MagnusKos/SlotRa_PCB/SlotRa.kicad_pcb

## KiCad design SlotRa.kicad_pcb (2025-05-28)

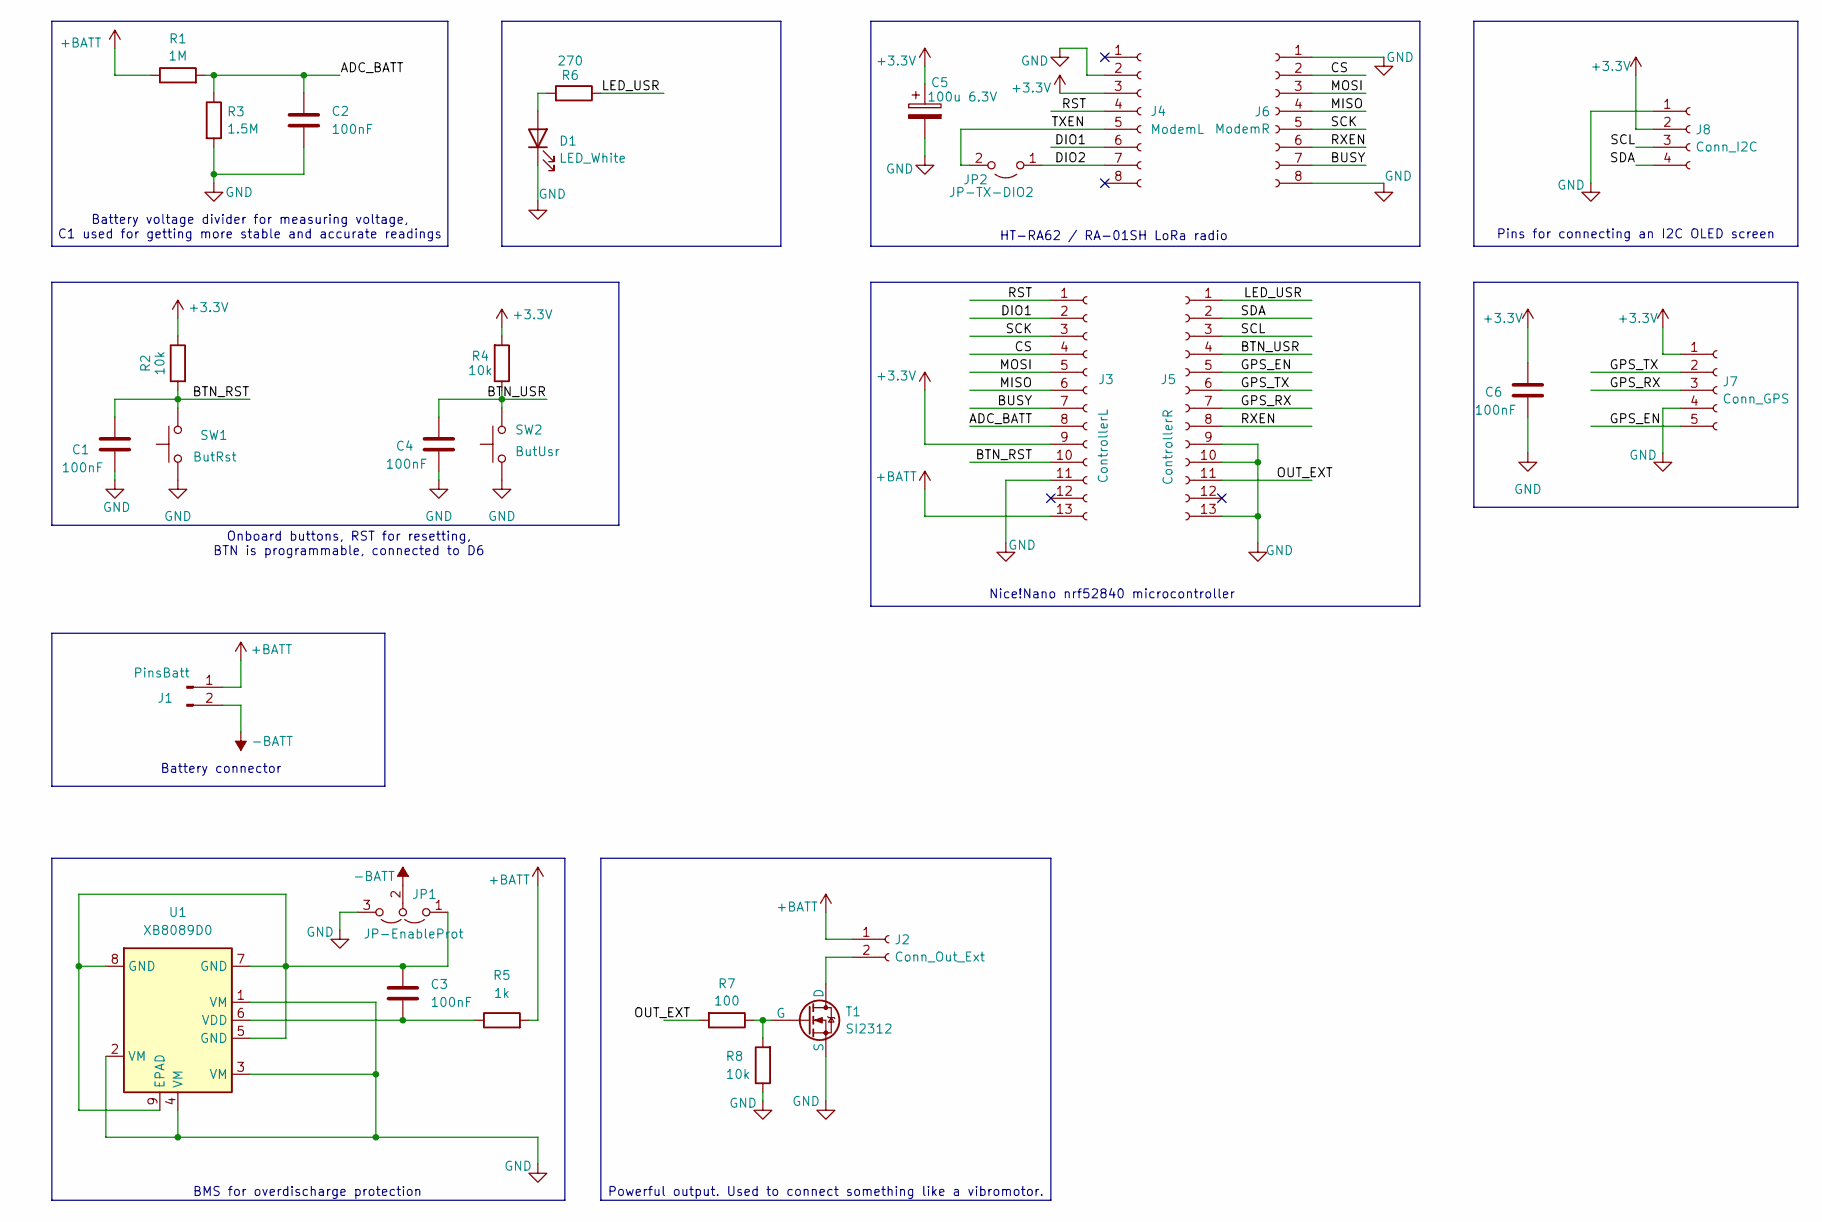
[picture p4: schematic SlotRa.kicad_sch, SlotRa (fakeTec_v5 mod)]

Parts:
C1, C2, C3, C4, C6: 100nF; C_0805_2012Metric_Pad1.18x1.45mm_HandSolder
C5: 100u 6.3V; CP_EIA-7343-31_Kemet-D
D1: LED_White; LED_D3.0mm_Horizontal_O6.35mm_Z10.0mm
J1: PinsBatt; PinHeader_1x02_P2.54mm_Vertical
J2: Conn_Out_Ext; PinHeader_1x02_P2.54mm_Vertical
J3: ControllerL; SMD_Pad_Row_P2.54_13x1
J4: ModemL; SMD_Pad_Row_P2.00_8x1_longer
J5: ControllerR; SMD_Pad_Row_P2.54_13x1
J6: ModemR; SMD_Pad_Row_P2.00_8x1
J7: Conn_GPS; PinHeader_1x05_P2.00mm_Vertical
J8: Conn_I2C; PinHeader_1x04_P2.54mm_Vertical
JP1: JP-EnableProt; SolderJumper-3_P1.3mm_Open_RoundedPad1.0x1.5mm
JP2: JP-TX-DIO2; SolderJumper-2_P1.3mm_Open_RoundedPad1.0x1.5mm
R1: 1M; R_0805_2012Metric_Pad1.20x1.40mm_HandSolder
R2, R4, R8: 10k; R_0805_2012Metric_Pad1.20x1.40mm_HandSolder
R3: 1.5M; R_0805_2012Metric_Pad1.20x1.40mm_HandSolder
R5: 1k; R_0805_2012Metric_Pad1.20x1.40mm_HandSolder
R6: 270; R_0805_2012Metric_Pad1.20x1.40mm_HandSolder
R7: 100; R_0805_2012Metric_Pad1.20x1.40mm_HandSolder
SW1: ButRst; KLS7-TS6335
SW2: ButUsr; PinHeader_1x02_P2.54mm_Vertical
T1: SI2312; TSOT-23_HandSoldering_Updated
U1: XB8089D0; SOIC-8-1EP_3.9x4.9mm_P1.27mm_EP2.41x3.3mm

Connections:
+3.3V: C5.1, C6.2, J3.9, J4.3, J7.1, J8.2, R2.1, R4.2
+BATT: J1.1, J2.1, J3.13, R1.1, R5.2
-BATT: J1.2, JP1.2 (C)
/ADC_BATT: C2.1, J3.8, R1.2, R3.1
/BTN_RST: C1.1, J3.10, R2.2, SW1.2
/BTN_USR: C4.2, J5.4, R4.1, SW2.2
/BUSY: J3.7, J6.7
/CS: J3.4, J6.2
/DIO1: J3.2, J4.6
/DIO2: J4.7, JP2.1 (A)
/GPS_EN: J5.5, J7.5
/GPS_RX: J5.7, J7.3
/GPS_TX: J5.6, J7.2
/LED_USR: J5.1, R6.1
/MISO: J3.6, J6.4
/MOSI: J3.5, J6.3
/OUT_EXT: J5.11, R7.2
/RST: J3.1, J4.4
/RXEN: J5.8, J6.6
/SCK: J3.3, J6.5
/SCL: J5.3, J8.3
/SDA: J5.2, J8.4
/TXEN: J4.5, JP2.2 (B)
GND: C1.2, C2.2, C4.1, C5.2, C6.1, D1.1 (K), J3.11, J4.2, J5.9, J5.10, J5.13, J6.1, J6.8, J7.4, J8.1, JP1.3 (B), R3.2, R8.1, SW1.1, SW2.1, T1.3 (S), U1.1 (VM), U1.2 (VM), U1.3 (VM), U1.4 (VM)
unnamed: D1.2 (A), R6.2
unnamed: J2.2, T1.1 (D)
unnamed: C3.1, JP1.1 (A), U1.5 (GND), U1.7 (GND), U1.8 (GND), U1.9 (EPAD)
unnamed: R7.1, R8.2, T1.2 (G)
unnamed: C3.2, R5.1, U1.6 (VDD)

Notes on the sheet:
Nice!Nano nrf52840 microcontroller
Powerful output. Used to connect something like a vibromotor.
BMS for overdischarge protection
Battery voltage divider for measuring voltage, C1 used for getting more stable and accurate readings
HT-RA62 / RA-01SH LoRa radio
Onboard buttons, RST for resetting, BTN is programmable, connected to D6
Battery connector
Pins for connecting an I2C OLED screen

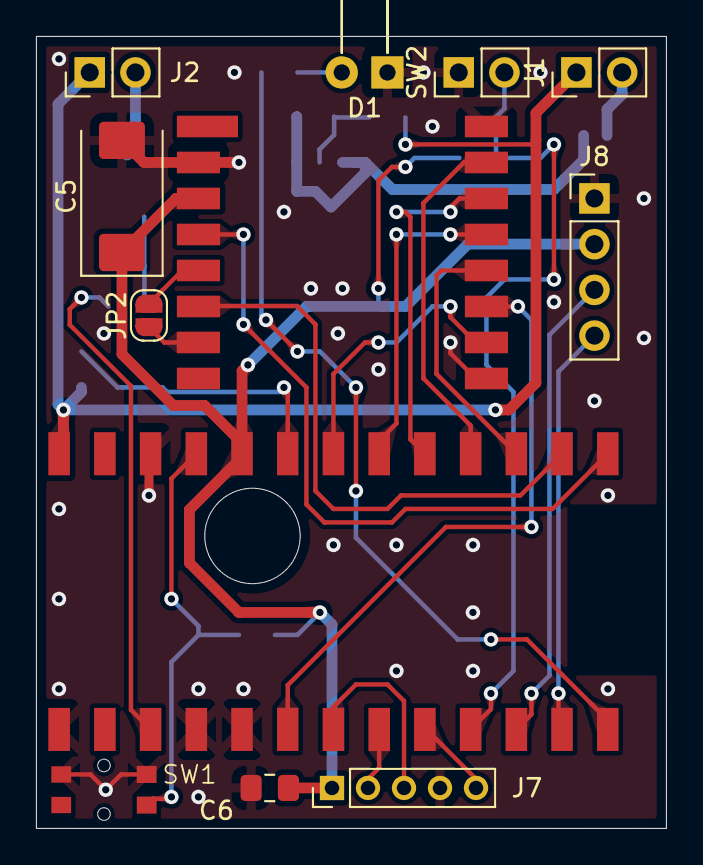
[picture p5: board SlotRa.kicad_pcb from above]

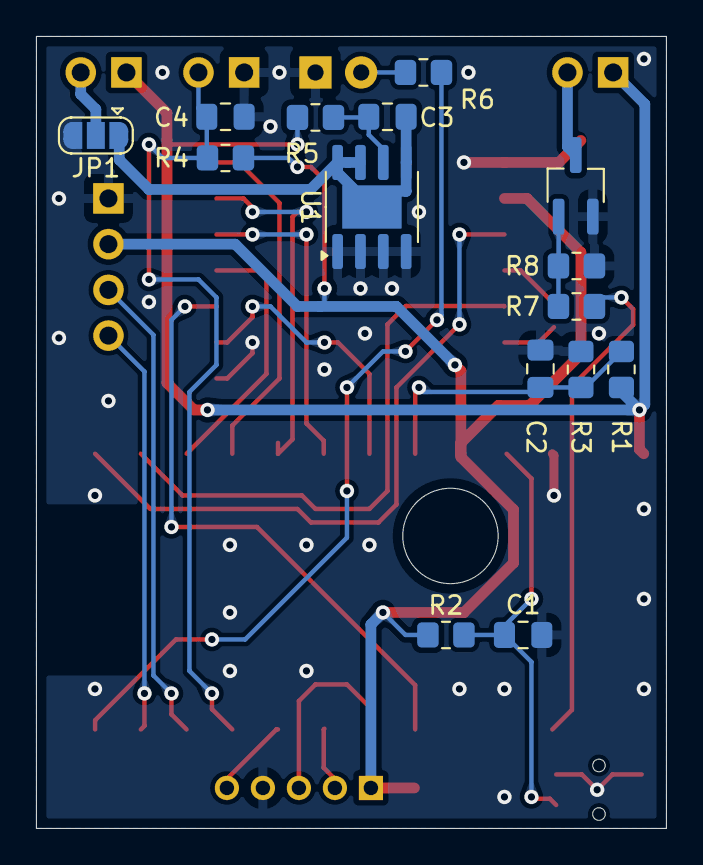
[picture p6: board SlotRa.kicad_pcb from below]

Board: 2 copper layers, 35.0 x 44.0 mm, 29 parts (15 on the bottom side), 29 nets.
