MagnusKos/SlotRa_PCB/(commit log)

2025-05-23 Structure cleansing
    Unpacked archive in the root: archived files are the project files.
    Excluded gerbers: these files are generated ones, they'll become Released ones.
    Deleted pics: new images are coming.
    [fakeTecv5.kicad_pcb, fakeTecv5.kicad_sch]
2025-05-24 Project renaming, cleansing and small additions
    Renamed kicad files.
    Performed some beautifications in the schematics for a better readability.
    Added gate resistors.
    Added arbitrary led for notifications.
    Added an e-capacitor for the modem powering filtering and stability improvements.
    [SlotRa.kicad_pcb, SlotRa.kicad_sch]
2025-05-24 Honey, I Shrunk The Footprints
    1206 caps and ress are 0805 now. They're cheaper, have suitable voltage and power ratings, and are still easy to solder.
    Also the author have a bunch of them, but not the 1206 ones...
    [SlotRa.kicad_sch]
2025-05-24 TXEN - DIO2 jumper
    It is unknown why these modem pads are hard-connected. If one needs this behavior - there is a jumper for it now.
    [SlotRa.kicad_sch]
2025-05-25 Buses renaming, power reconnection
    I can't understand why there are labeled connections with creepy names that doubles already existing buses. So, say goodbye to that labels and say hello to clean and logical named bus symbols.
    Also renamed Batt-Percent. Looks like some kind of expression, but actually it is indeed a connection to voltage-measuring line. I prefer ADC_BATT for that purpose.
    Renamed jumpers' labels.
    Deleted one of the battery connectors: no need to use redundancy in this fork.
    [SlotRa.kicad_sch]
2025-05-25 GPS port and uC-PCB schematics
    And now the PCB's pin-headers become readable in the schematics.
    GPS's pins are separated, I dunno why they used 4-pin pads with attached user button, but no power buses at all. Now there are 5-pin pads with mandatory power and data lines and an optional enable signal.
    Removed the first power mosfet that also could regulate GPS's power. Let's make it something external. What if the GPS unit already has EN signal?
    [SlotRa.kicad_sch]
2025-05-27 Transistors purging and more adjustments
    And now there is only one power MOSFET. One can connect it to a vibromotor, for example. Also it uses pin-header with 2 pins: 1 connected to a battery line and one - to the MOSFET.
    There are also some minor schematic and symbols adjustments.
    [SlotRa.kicad_sch]
2025-05-28 Finally, The PCB
    Small fixes in the schematics.
    Recreated the PCB. A toucght one, there were too many wrong decisions that led to a non-upgradability of the project without the Power Of Some Mother And The Sledgehammer.
    [SlotRa.kicad_pcb, SlotRa.kicad_sch]
2025-05-28 Custom footprints library
    This project initially used a lot of custom-made (or ported) footprints, that breaks by the easiest blow of the wind. So, here is a library. With all the things, that are used in the project.
2025-05-28 Eye candy for the PCB
    I like rounded tracks. No more to say.
    So here are static project files with a rounded tracks. They are not connected to the schematics (kinda) and to the original PCB, so use 'em and be warned about a lag.
    [SlotRa-rounded.kicad_pcb]
2025-05-28 Quick Fix: MOSFET line
    Just a quick fix: T1 Drain circuit was too thin. It's in the Power family now, so the line is thick.
    [SlotRa-rounded.kicad_pcb, SlotRa.kicad_pcb, SlotRa.kicad_sch]
2025-07-17 A bunch of photos
    Added some crappy photos of the PCB.
    Integrated photos in Readme.md.
